jrevelldev/esp32-ultrasonic-touchdesigner/docs/assets/qr-guia-imprimible.pdf

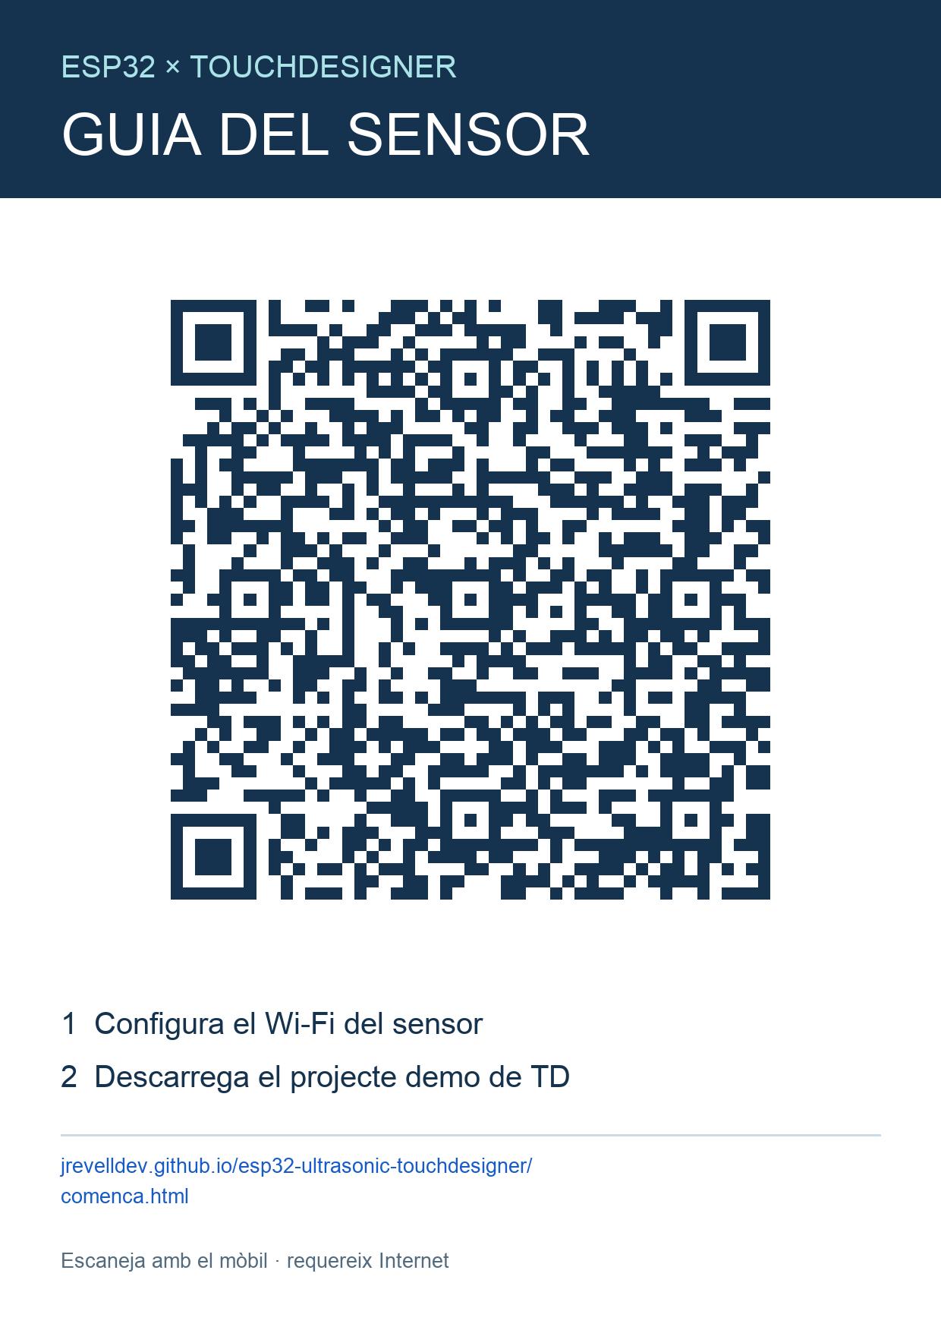
[picture p2: page 1]
