jrevelldev/esp32-ultrasonic-touchdesigner/docs/assets/corrent-divisor.png

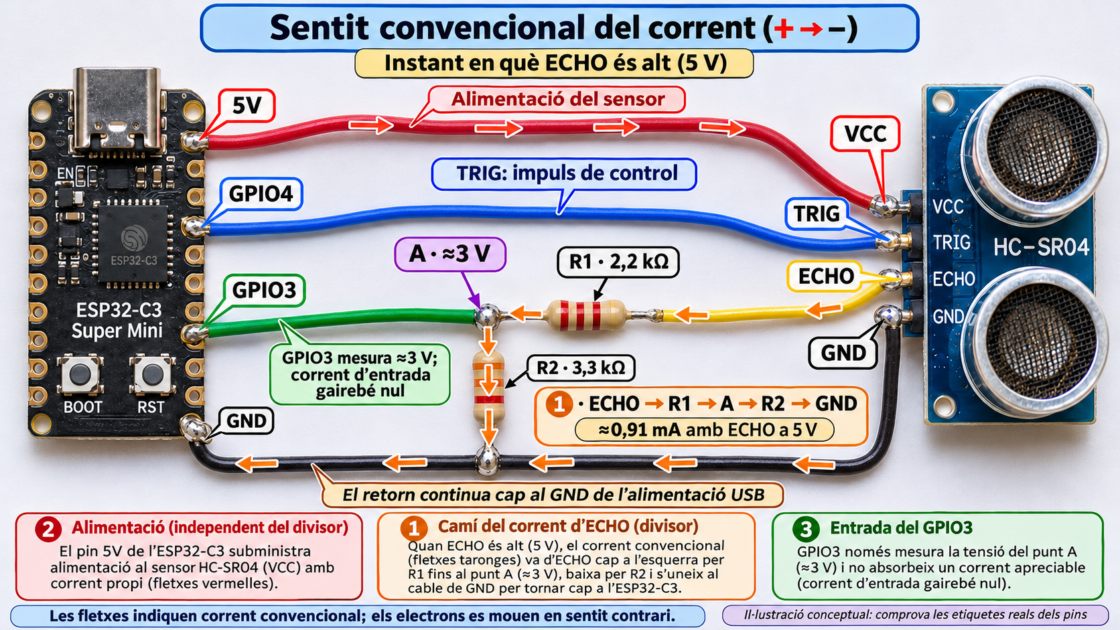
docs/assets/corrent-divisor.png
