jrevelldev/esp32-ultrasonic-touchdesigner/docs/assets/muntatge-explotat-caixa.png

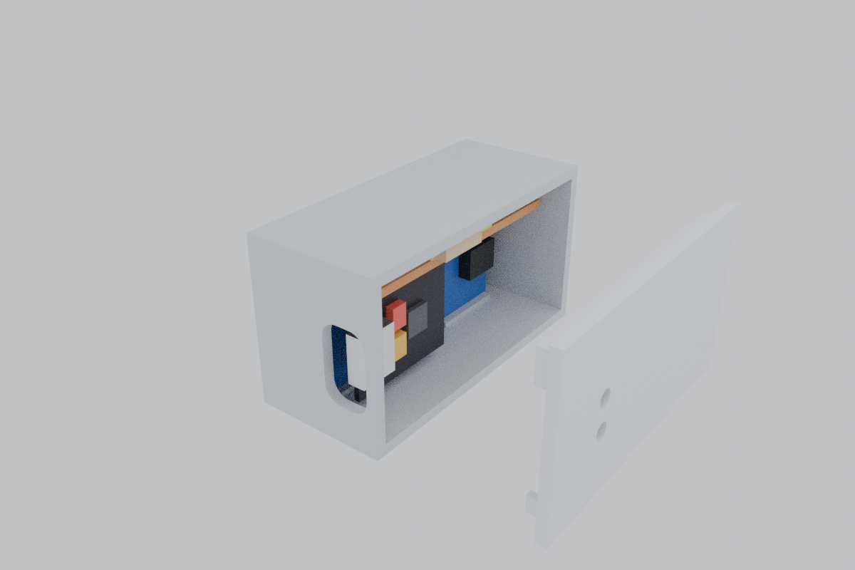
docs/assets/muntatge-explotat-caixa.png
