jrevelldev/esp32-ultrasonic-touchdesigner/docs/assets/qr-guia.png

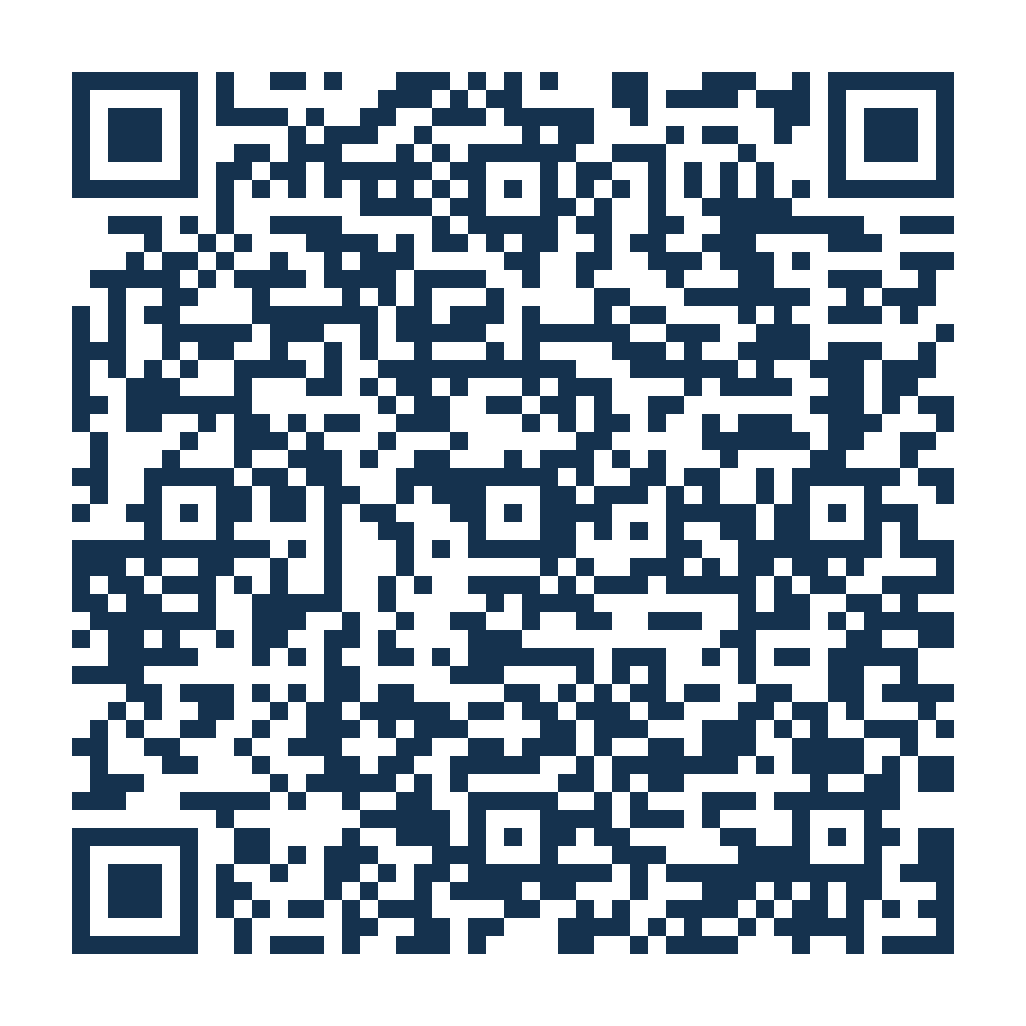
docs/assets/qr-guia.png
