jrevelldev/esp32-ultrasonic-touchdesigner/docs/assets/referencies/esp32-c3-frontal.png

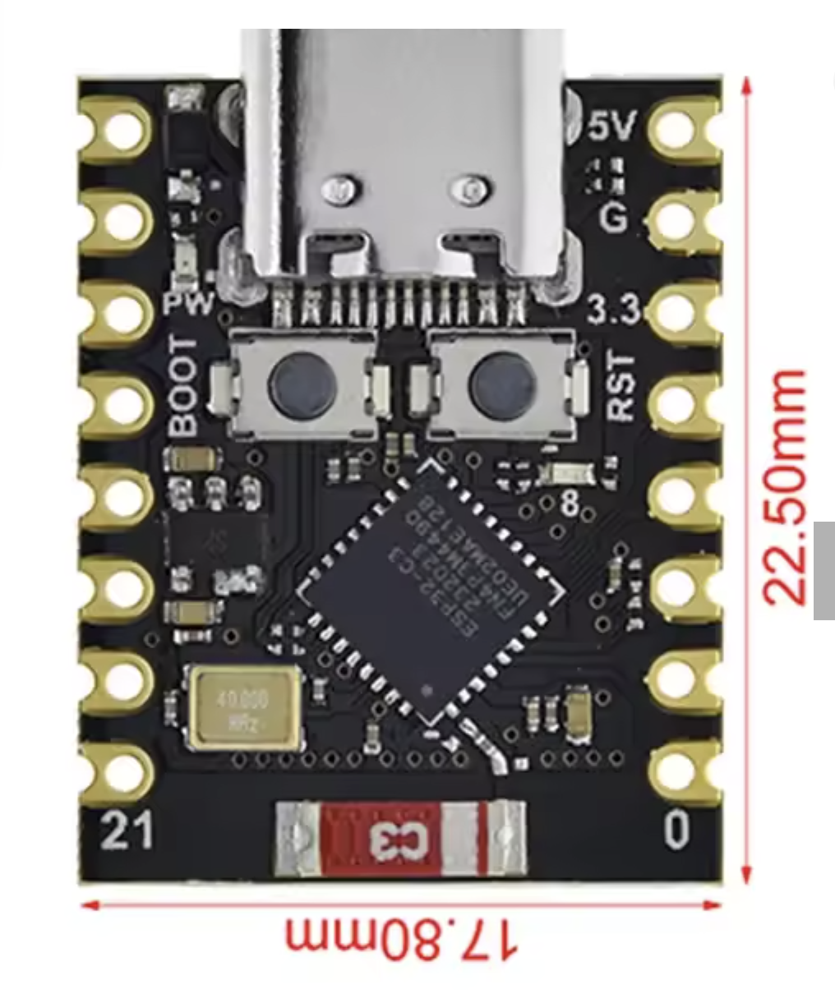
docs/assets/referencies/esp32-c3-frontal.png
