jrevelldev/esp32-ultrasonic-touchdesigner/docs/assets/referencies/esp32-c3-posterior.png

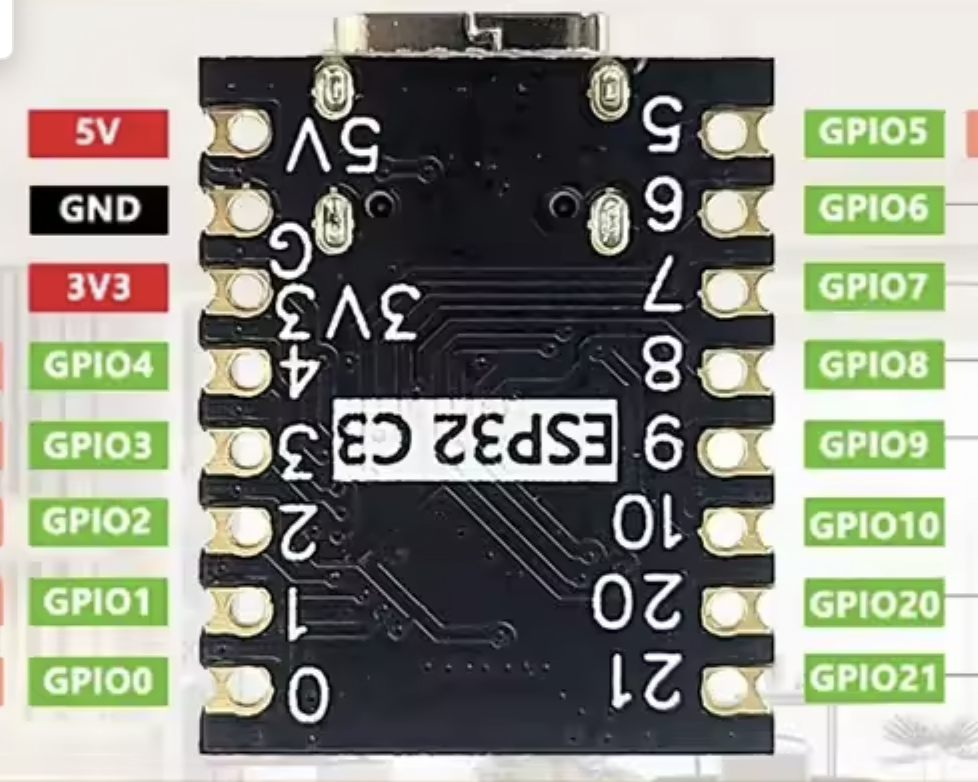
docs/assets/referencies/esp32-c3-posterior.png
