jrevelldev/esp32-ultrasonic-touchdesigner/docs/assets/referencies/hc-sr04-frontal.png

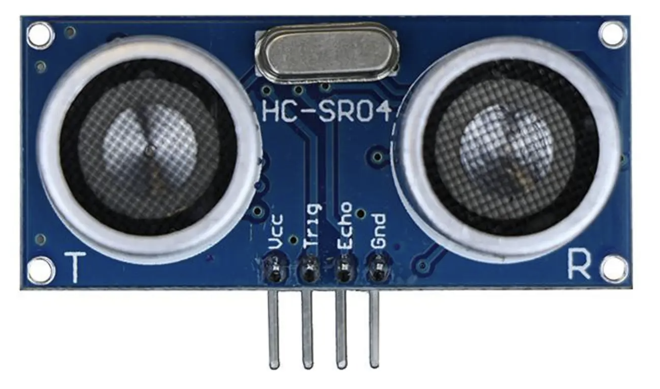
docs/assets/referencies/hc-sr04-frontal.png
