jrevelldev/esp32-ultrasonic-touchdesigner/docs/assets/touchdesigner-prova.png

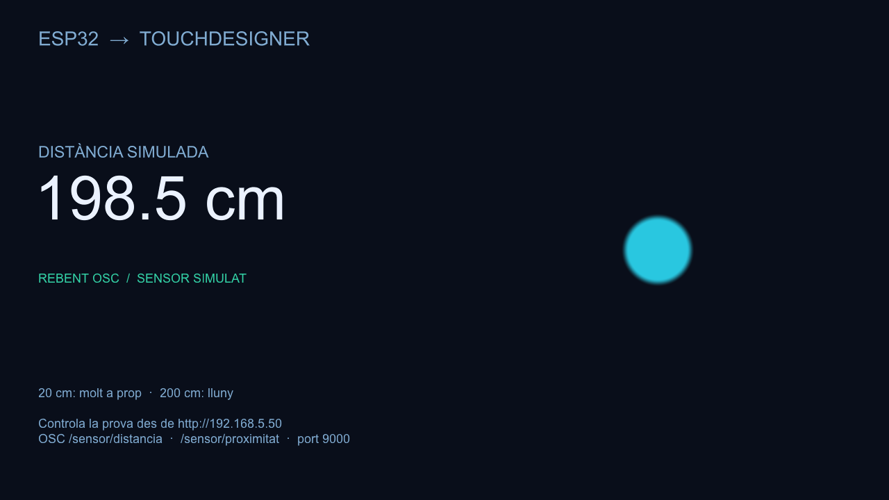
docs/assets/touchdesigner-prova.png
