jrevelldev/esp32-ultrasonic-touchdesigner/docs/downloads/Esquema_ESP32_HCSR04.png

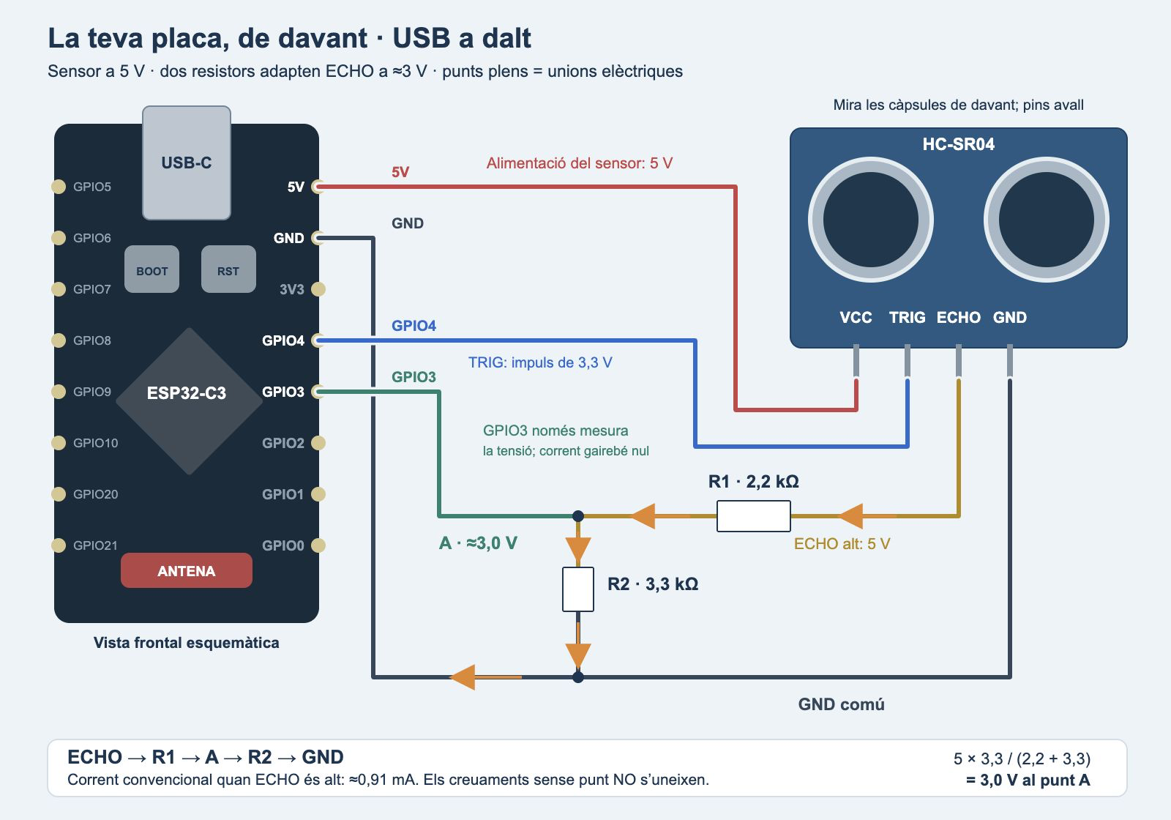
docs/downloads/Esquema_ESP32_HCSR04.png
