jrevelldev/esp32-ultrasonic-touchdesigner/hardware/enclosure/vista_frontal.png

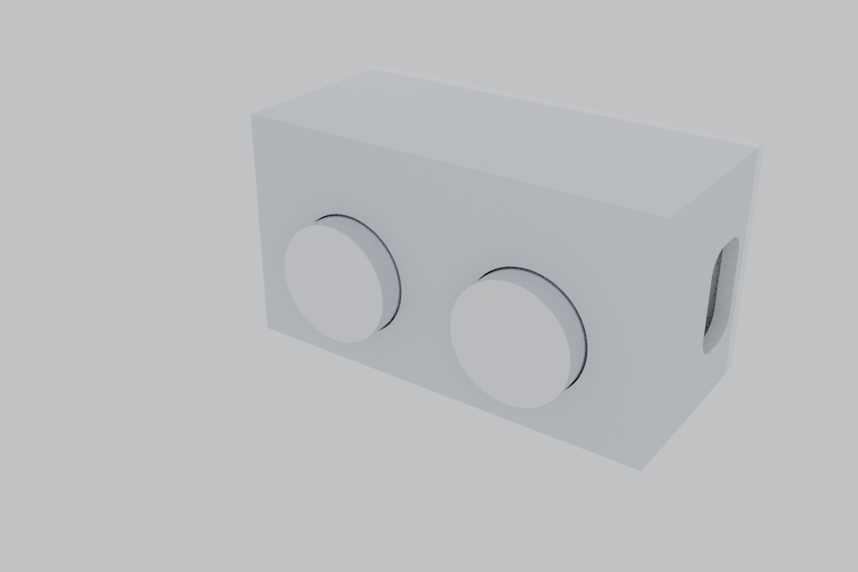
hardware/enclosure/vista_frontal.png
