jrevelldev/esp32-ultrasonic-touchdesigner/hardware/enclosure/sensor_box_body.stl

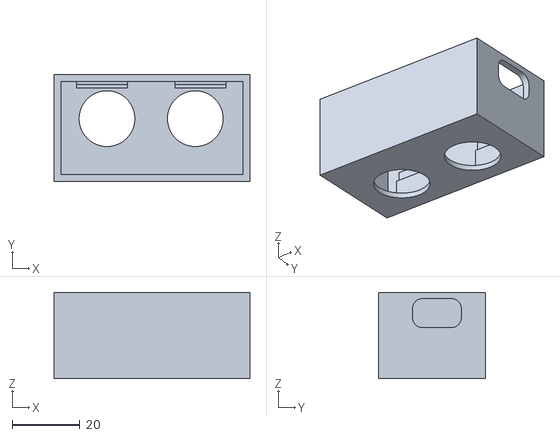
[picture p12: CAD file, 2026-11-11]
hardware/enclosure/sensor_box_body.stl
57.7 x 31.5 x 25.4
