jrevelldev/esp32-ultrasonic-touchdesigner/hardware/enclosure/sensor_box_lid.stl

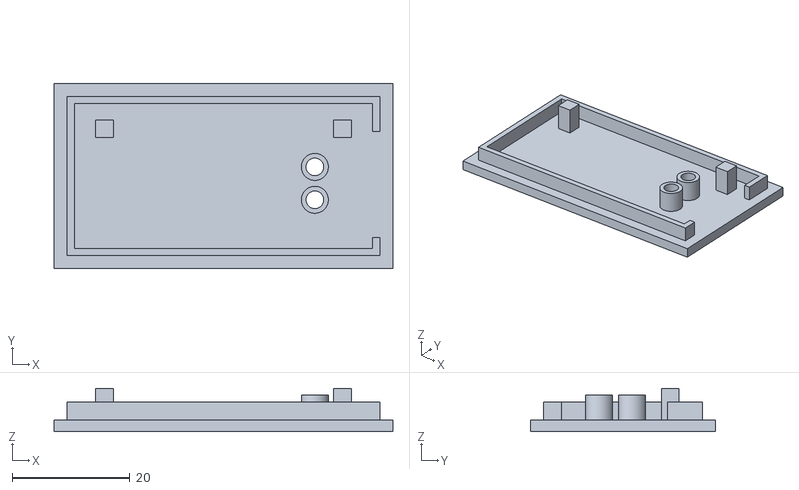
[picture p13: CAD file, 2026-11-11]
hardware/enclosure/sensor_box_lid.stl
57.7 x 31.5 x 7.35
