jrevelldev/esp32-ultrasonic-touchdesigner/hardware/enclosure/electronics_model.stl

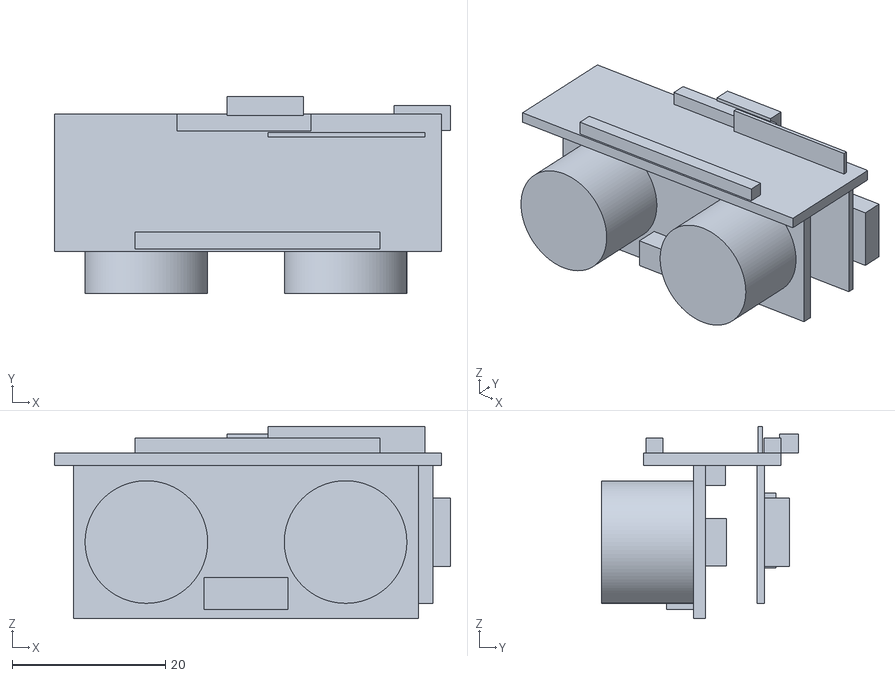
[picture p14: CAD file, 2026-11-11]
hardware/enclosure/electronics_model.stl
51.7 x 25.7 x 25.1
