jrevelldev/esp32-ultrasonic-touchdesigner/(list of files, cad)

Other CAD files:
hardware/enclosure/sensor_box.blend
hardware/enclosure/sensor_box_assembled.blend
