jrevelldev/esp32-ultrasonic-touchdesigner/hardware/enclosure/seccio_verificacio.png

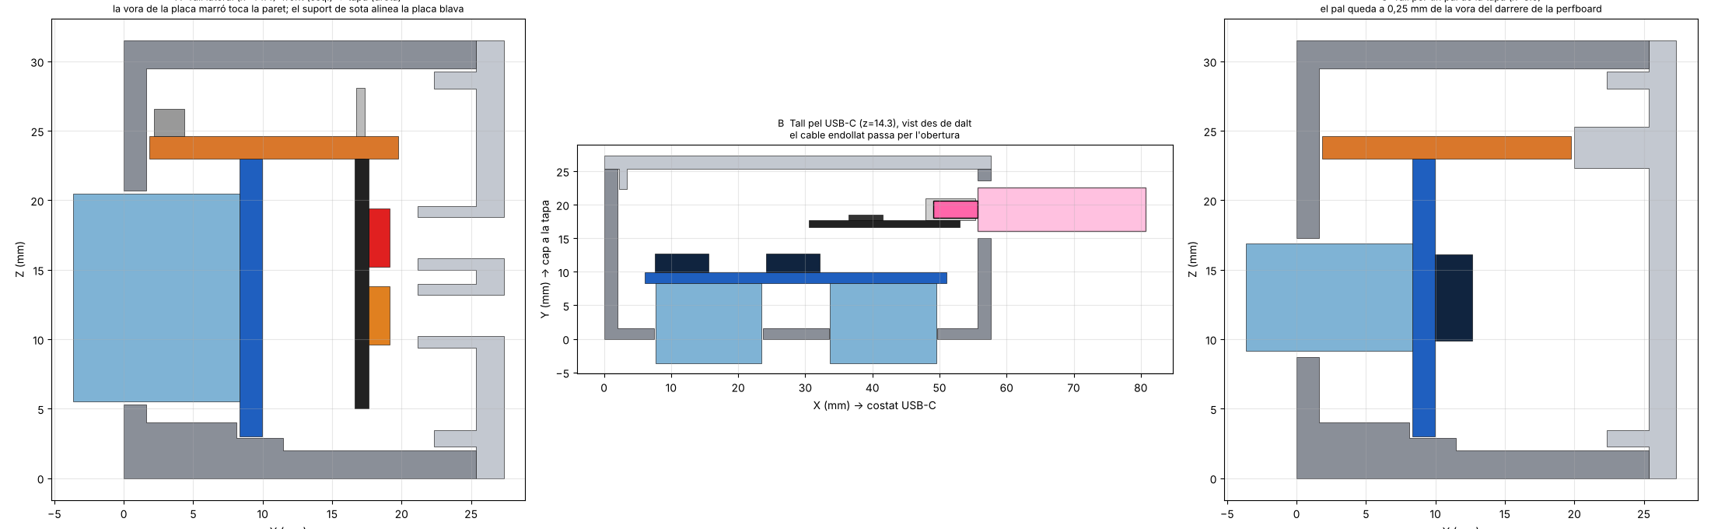
hardware/enclosure/seccio_verificacio.png
