jrevelldev/esp32-ultrasonic-touchdesigner/docs/downloads/Actualitza_sensor_real.py

"""Executa a Textport amb exec(open('/ruta/Actualitza_sensor_real.py').read()).
Actualitza etiquetes, validesa i afegeix canals raw/filtrats; conserva els nodes existents.
"""
from pathlib import Path
import json

c=op('/project1/esp32_demo')
if c is None:
    raise RuntimeError('Obre primer el projecte ESP32 TouchDesigner.')
c.op('helpers').text='''import time

def value(suffix, default=0.0):
    try:
        for channel in me.parent().op('osc_in').chans():
            if channel.name.endswith(suffix):
                return float(channel[0])
    except Exception:
        pass
    return default

def online():
    return time.monotonic() - me.parent().fetch('last_seen', -1e12) < 1.5

def valid():
    return online() and value('valid', 1) > 0.5 and value('distancia', -1) >= 0

def source_label():
    if not online(): return 'ESPERANT DADES'
    return 'DISTÀNCIA SIMULADA' if value('simulat', 1) > 0.5 else 'DISTÀNCIA REAL'

def distance_text():
    return ('%.1f cm' % value('distancia')) if valid() else '-- cm'

def status_text():
    if not online(): return 'ESPERANT L’ESP32  /  OSC'
    if value('simulat', 1) > 0.5: return 'REBENT OSC  /  SENSOR SIMULAT'
    return 'REBENT OSC  /  SENSOR REAL' if valid() else 'SENSOR REAL  /  SENSE ECO VÀLID'
'''
c.op('label').par.text.expr="op('helpers').module.source_label()"
if getattr(c.par, 'Nearcm', None) is None:
    c.op('footer').par.text='20 cm: molt a prop  ·  200 cm: lluny\n\nHC-SR04 · TRIG GPIO4 · ECHO GPIO3\nOSC /sensor/distancia · /sensor/proximitat'
# Canals separats per comparar el senyal i decidir on filtrar.
rx=c.op('osc_in')
for name,pattern,y in [('raw_cm','*raw',-550),('filtrada_esp_cm','*filtrada',-650),('validesa','*valid',-750),('interval_ms','*interval_ms',-850),('echo_us','*echo_us',-950)]:
    node=c.op(name) or c.create(selectCHOP,name)
    node.inputConnectors[0].connect(rx)
    node.par.channames=pattern
    node.par.renamefrom='*'
    node.par.renameto=name
    node.nodeX,node.nodeY=450,y
    node.viewer=True
lag=c.op('suavitzat_td') or c.create(lagCHOP,'suavitzat_td')
lag.inputConnectors[0].connect(c.op('raw_cm'))
lag.par.lagunit = 'seconds'
if getattr(c.par, 'Smoothing', None) is None:
    lag.par.lag1=0.15
    lag.par.lag2=0.15
lag.nodeX,lag.nodeY=700,-550
lag.viewer=True
# La mida de la bola segueix una transició contínua entre mostres OSC.
sizeLag=c.op('mida_suau') or c.create(lagCHOP,'mida_suau')
sizeLag.inputConnectors[0].connect(c.op('proximitat'))
sizeLag.par.lagunit='seconds'
sizeLag.par.lag1=0.25
sizeLag.par.lag2=0.25
sizeLag.par.timeslice=True
sizeLag.nodeX,sizeLag.nodeY=700,-80
sizeLag.viewer=True
circle=c.op('proximity_circle')
if getattr(c.par, 'Nearcm', None) is None:
    circle.par.radiusx.expr="0.04 + 0.13 * max(0, min(1, op('mida_suau')[0])) + 0 * absTime.seconds"
    circle.par.radiusy.expr="me.par.radiusx"
c.op('LLEGEIX_ME').text = '''ESP32-C3 · HC-SR04 · OSC

raw_cm: distància sense filtre en cm.
filtrada_esp_cm: sortida EMA de l’ESP (igual a raw si desactivat).
suavitzat_td: Lag CHOP de prova de 0,15 segons sobre raw_cm.
validesa: 1 mesura vàlida; 0 sense eco. No utilitzis −1 com a distància.
interval_ms: interval real entre mesures. echo_us: pols ECHO en microsegons.
distancia_cm i el text del panell utilitzen la sortida seleccionada a la web de l’ESP.
mida_suau: Lag CHOP de 0,25 s que anima només la mida de la bola.
Augmenta Lag Up/Down per una transició més lenta; redueix-los per més resposta.

A la web: Lectura i suavitzat → Raw per filtrar només a TD.
Les dades venen de l’ESP; TD no genera cap distància.
'''
errors={n.name:n.errors() for n in c.children if n.errors()}
if errors: raise RuntimeError(str(errors))
out=Path(project.folder)
c.save(str(out/'Prova_ESP32_TouchDesigner.tox'))
project.save(str(out/'Prova_ESP32_TouchDesigner.toe'))
print('Panell actualitzat: raw, EMA ESP, Lag TD 0,15 s; errors:', errors)
print('Canals raw:', [ch.name for ch in c.op('raw_cm').chans()], 'Lag unit:', lag.par.lagunit.eval())
