jrevelldev/esp32-ultrasonic-touchdesigner/(commit log)

2026-11-07 Afegeix projecte ESP32, esquemes i guia interactiva per a Pages
2026-11-07 Actualitza el cablejat amb la placa real i explica les opcions de 3,3 V
2026-11-08 Evita salts del formulari en actualitzar la telemetria
2026-11-08 Suavitza la bola a TD i enllaça la descàrrega des del sensor
2026-11-08 Tanca la guia amb QR i controls visuals de TouchDesigner
2026-11-08 Ajusta la mida de la il·lustració de la guia ràpida
2026-11-08 Explica BOOT i RESET des de zero a la guia ràpida
2026-11-08 Destaca els botons per configurar el sensor al QR
2026-11-08 Suavitza la bola quan es perd la lectura OSC
2026-11-11 Add printable sensor enclosure and guide download
    [electronics_model.stl, sensor_box.blend, sensor_box_assembled.blend, sensor_box_body.stl, sensor_box_lid.stl]
